Ttyzsx/telepole-survey-meter/30503_0.jpg

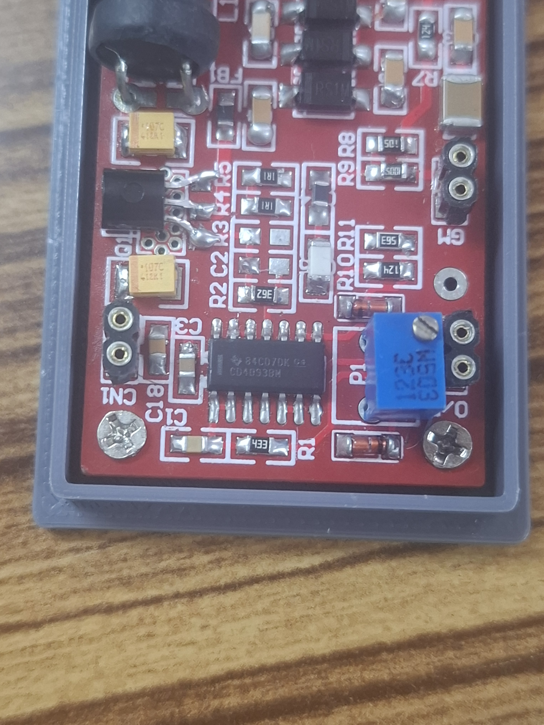
30503_0.jpg
