Ttyzsx/telepole-survey-meter/30507.jpg

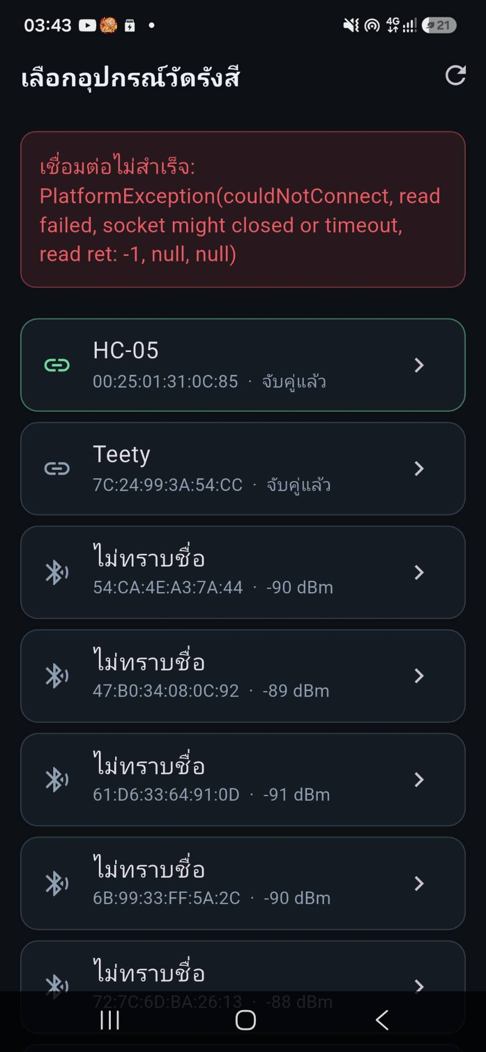
30507.jpg
