Ttyzsx/telepole-survey-meter/docs/telepole-manual-slides-v3.pptx

นำเสนอสรุปคู่มือ
ไกเกอร์เคาน์เตอร์ LND712 ทำงานอย่างไร
เดินตามสัญญาณหนึ่งเส้น ตั้งแต่รังสีเข้าหลอด จนถึงตัวเลขบนจอและเสียงเตือน

Notes: เปิดด้วยประโยคเดียว: คู่มือเล่มนี้พาสร้างไกเกอร์เคาน์เตอร์ที่วัดรังสีแล้วส่งค่าขึ้นมือถือ
บอกวิธีที่จะเล่า: ผมจะไม่ไล่ตามสารบัญ แต่จะเดินตามสัญญาณเส้นเดียวตั้งแต่รังสีเข้าหลอด
จนถึงเสียงเตือน เพราะทุกบรรทัดในโค้ดอยู่บนเส้นนี้หมด

## Slide 2

โครงเรื่อง

ทุกอย่างในเครื่องนี้อยู่บนสัญญาณเส้นเดียว

— สไลด์ต่อจากนี้ไล่ทีละขั้น พร้อมโค้ดจริงจากคู่มือที่รับผิดชอบขั้นนั้น
— กล่องสีเหลืองด้านขวาคือเหตุผลว่าทำไมคู่มือถึงเขียนแบบนั้น ซึ่งคู่มือไม่ได้อธิบายไว้
— รายการอุปกรณ์ ตารางขา และการแก้ปัญหา อยู่ในภาคผนวกท้ายเล่ม

รังสี
อนุภาคผ่านหลอด

พัลส์
0-5V เข้าขา D2

นับ
interrupt เก็บจำนวน

CPM
x6 ทุก 10 วินาที

หัก BG
ลบรังสีพื้นหลัง

uSv/h
x conversion factor

เตือน
เทียบ threshold

>

>

>

>

>

>

Notes: ชี้ที่โซ่แล้วอ่านจากซ้ายไปขวา: รังสีเข้าหลอด กลายเป็นพัลส์ นับด้วย interrupt
รวมเป็น CPM หักพื้นหลัง คูณ factor ได้ไมโครซีเวิร์ต แล้วเทียบเกณฑ์เตือน
บอกว่า 7 กล่องนี้คือ 7 สไลด์ถัดไป และแถบล่างของทุกหน้าจะบอกว่าอยู่ขั้นไหน

## Slide 3

ก่อนเข้าโค้ด

โครงสร้างของไฟล์ sketch ทั้งไฟล์

telepole_gm.ino — ภาพรวม

#include <Wire.h>

#include <Adafruit_SSD1306.h>

#include <Adafruit_GFX.h>

#include <SoftwareSerial.h>

// ตั้งค่าหน้าจอ OLED
#define SCREEN_WIDTH 128

#define SCREEN_HEIGHT 64

#define OLED_ADDR 0x3C

Adafruit_SSD1306 display(SCREEN_WIDTH, SCREEN_HEIGHT, &Wire, -1);
// กำหนดขาต่ออุปกรณ์
#define GEIGER_PIN 2 // พัลส์จากโมดูล HV (interrupt 0)

#define BUTTON_SEL 3 #define BUTTON_UP 4

#define BUTTON_DN 5 #define BUZZER_PIN 6

#define BT_RX 7 #define BT_TX 8

SoftwareSerial bluetooth(BT_RX, BT_TX);
// ฟังก์ชันทั้งหมดในไฟล์ มี 8 ตัว
countPulse() readButton() triggerAlert()
updateDisplay() sendBluetoothData() handleMenu()
setup() loop()

ฟังก์ชัน 8 ตัว แบ่งได้ 3 กลุ่ม
กลุ่มที่ 1 อยู่บนเส้นทางสัญญาณ — countPulse, triggerAlert, updateDisplay, sendBluetoothData
กลุ่มที่ 2 รับคำสั่งจากผู้ใช้ — readButton, handleMenu
กลุ่มที่ 3 โครงของโปรแกรม — setup ทำครั้งเดียว, loop วนตลอด
สไลด์ต่อจากนี้จะไล่ครบทั้ง 8 ตัว ไม่มีตกหล่น

Notes: หน้านี้ไว้ตอบล่วงหน้าว่าโค้ดทั้งไฟล์มีอะไรบ้าง จะได้ไม่มีใครสงสัยว่าข้ามอะไรไป
บอกว่าไฟล์เดียวจบ ไม่ได้แยกหลายไฟล์ และมีฟังก์ชัน 8 ตัว
ชี้ที่กล่องขวา แล้วบอกว่าจะเล่าเรียงตามเส้นทางสัญญาณ ไม่ใช่เรียงตามลำดับในไฟล์

## Slide 4

ขั้นที่ 1

จากรังสีกลายเป็นพัลส์ไฟฟ้า

— หลอด LND712 บรรจุแก๊ส มีขั้วไฟฟ้าต่างศักย์กัน ต้องการแรงดัน 450-650V
— อนุภาครังสีผ่านเข้าไป ทำให้แก๊สแตกตัว เกิดการนำไฟฟ้าชั่วขณะ
— ได้พัลส์แรงดันสั้นมาก หนึ่งลูกต่อหนึ่งอนุภาค
— โมดูลจ่ายแรงดันสูงจัดรูปพัลส์ให้เป็นสัญญาณ TTL 0-5V ก่อนส่งเข้า Arduino
— คู่มือแนะนำให้ตั้งแรงดันไว้ประมาณ 500V
— ขั้นนี้ยังไม่มีโค้ด เป็นฮาร์ดแวร์ล้วน

ข้อจำกัดที่ต้องรู้ตั้งแต่ต้น
หลอด GM บอกได้แค่ว่ามีอนุภาคผ่าน ไม่ได้บอกว่าเป็นรังสีชนิดใดหรือพลังงานเท่าไร
ทุกตัวเลขที่เหลือในเครื่องนี้จึงเป็นการตีความจากการนับล้วน ๆ
คู่มือเตือนว่า 400-550V เป็นอันตราย ต้องหุ้มฉนวนและระวังขณะต่อวงจร

1. พัลส์

2. นับ

3. CPM

4. หัก BG

5. µSv/h

6. เตือน

7. ส่งออก

Notes: เริ่มจากฟิสิกส์ก่อน อย่าเพิ่งเข้าโค้ด
อธิบายว่าหลอดคือหลอดแก๊สที่มีไฟแรงสูงคร่อมอยู่ พอมีอนุภาควิ่งผ่านก็ทำให้แก๊สแตกตัว
เกิดกระแสวูบเดียว ได้พัลส์ออกมาหนึ่งลูก
ย้ำประโยคสำคัญ: หลอดนับได้อย่างเดียว บอกชนิดรังสีไม่ได้ ตรงนี้จะใช้อ้างอิงอีกครั้งตอนขั้นที่ 5

## Slide 5

ขั้นที่ 2 · countPulse()

จับพัลส์ให้ครบด้วย Interrupt

countPulse() และการตั้งค่าใน setup()

volatile unsigned long pulseCount = 0;
// ฟังก์ชัน Interrupt: ทำงานทุกครั้งที่เกิดพัลส์
void countPulse() {
pulseCount++;
}
// ใน setup()
pinMode(GEIGER_PIN, INPUT);
attachInterrupt(digitalPinToInterrupt(GEIGER_PIN),
countPulse, RISING);

ทำไมต้องเป็นแบบนี้
พัลส์กว้างระดับไมโครวินาที ถ้าใช้ digitalRead ในลูปปกติจะอ่านไม่ทันและนับตกหล่น
ATmega328P มี external interrupt แค่ 2 ช่อง คือ D2 และ D3 จึงบังคับว่าสัญญาณต้องเข้าขานี้
โค้ดใน interrupt ยิ่งยาวยิ่งเสี่ยงพลาดพัลส์ลูกถัดไป จึงเหลือแค่บวกหนึ่ง
volatile บอกคอมไพเลอร์ว่าค่าถูกแก้จากนอกลูป ห้าม optimize ทิ้ง

1. พัลส์

2. นับ

3. CPM

4. หัก BG

5. µSv/h

6. เตือน

7. ส่งออก

Notes: หน้านี้เป็นหน้าที่ต้องเล่าให้ดีที่สุด เพราะเป็นจุดที่แสดงว่าเข้าใจจริง
อ่านโค้ดให้ฟังก่อน แค่ 3 บรรทัด แล้วถามกลับว่าทำไมฟังก์ชันมันสั้นแค่นี้
ตอบเอง: เพราะโค้ดใน interrupt ยิ่งยาวยิ่งเสี่ยงพลาดพัลส์ลูกถัดไป
แล้วอธิบาย volatile ว่าถ้าไม่ใส่ คอมไพเลอร์อาจมองว่าตัวแปรไม่เคยถูกแก้ในลูป แล้ว optimize ทิ้ง
ถ้าอาจารย์ถามว่าทำไมต้อง D2 ตอบว่าชิปมี external interrupt แค่ 2 ขา คือ D2 กับ D3

## Slide 6

ขั้นที่ 3 · loop()

นับสะสมแล้วแปลงเป็น CPM

ส่วนคำนวณใน loop()

const unsigned long SAMPLE_TIME = 10000; // 10 วินาที
const float MULTIPLIER = 60000.0 / SAMPLE_TIME; // = 6
if (millis() - lastSampleTime >= SAMPLE_TIME) {
// ปิด Interrupt ชั่วคราวขณะอ่านค่า pulseCount
noInterrupts();
unsigned long counts = pulseCount;
pulseCount = 0;
interrupts();
cpm = counts * MULTIPLIER;
}

ทำไมต้องปิด Interrupt ชั่วคราว
การอ่านค่าแล้วรีเซ็ตเป็นสองคำสั่ง ไม่ใช่คำสั่งเดียว
ถ้าพัลส์เข้ามาระหว่างสองคำสั่งนั้น มันจะถูกนับแล้วโดนล้างทิ้งทันที คือหายไปเลย
ปิดแค่สองบรรทัดจึงไม่ทำให้พลาดพัลส์ เพราะฮาร์ดแวร์จำสถานะค้างไว้ให้
คู่มือเลือก 10 วินาทีเพื่อให้ตัวเลขขึ้นเร็ว ไม่ต้องรอครบนาที

1. พัลส์

2. นับ

3. CPM

4. หัก BG

5. µSv/h

6. เตือน

7. ส่งออก

Notes: อธิบาย MULTIPLIER ก่อน: นับ 10 วินาที คูณ 6 ได้ค่าต่อนาที ไม่ต้องรอครบนาที
แล้วเน้นที่ noInterrupts จุดนี้อาจารย์น่าจะถาม
อธิบายว่าอ่านค่ากับรีเซ็ตเป็นคนละคำสั่ง ถ้าพัลส์แทรกตรงกลางจะหายไปเลย
เสริมว่าปิดแค่สองบรรทัดไม่ทำให้พลาดพัลส์ เพราะฮาร์ดแวร์จำไว้ให้ก่อน

## Slide 7

ขั้นที่ 4

หักค่ารังสีพื้นหลังออก

ส่วนหักพื้นหลังใน loop()

const float DEFAULT_BACKGROUND = 20.0; // CPM
float background = DEFAULT_BACKGROUND;
float adjustedCPM = cpm - background;
if (adjustedCPM < 0) adjustedCPM = 0;
// สูตรตามคู่มือ
// Adjusted_CPM = CPM - Background_CPM
// ถ้าติดลบ ให้แสดง 0 CPM / 0.00 uSv/h

ผลของการหักตรงนี้
คู่มือระบุว่ารังสีพื้นหลังจริงอยู่ราว 15-30 CPM ขึ้นกับสถานที่
วิธีหาค่า วัดในที่ที่ไม่มีแหล่งรังสีเพิ่มเติม 10-15 นาที แล้วเฉลี่ย
ตัวเลขที่เห็นจะสะท้อนเฉพาะรังสีที่เพิ่มมาจากแหล่งกำเนิด
ถ้าตั้งค่าพื้นหลังผิด ตัวเลขจะผิดตามไปทั้งหมด และย้อนดูค่าดิบไม่ได้

1. พัลส์

2. นับ

3. CPM

4. หัก BG

5. µSv/h

6. เตือน

7. ส่งออก

Notes: บอกว่าโลกเรามีรังสีพื้นหลังตลอดเวลา ประมาณ 15-30 CPM
ถ้าไม่หักออก เครื่องจะขึ้นตัวเลขตลอดทั้งที่ไม่มีแหล่งกำเนิด
อธิบายบรรทัด if adjustedCPM < 0 ว่ากันกรณีวัดได้ต่ำกว่าค่าที่ตั้งไว้ จะได้ไม่ขึ้นค่าติดลบ
ถ้าถูกถามข้อเสีย ตอบว่าถ้าตั้ง background ผิด ค่าที่ได้ผิดหมดและย้อนดูค่าดิบไม่ได้

## Slide 8

ขั้นที่ 5

แปลง CPM เป็นไมโครซีเวิร์ตต่อชั่วโมง

ส่วนแปลงหน่วย

const float DEFAULT_CONV_FACTOR = 0.00833;
float convFactor = DEFAULT_CONV_FACTOR;
doseRate = adjustedCPM * convFactor;
// ค่าที่คู่มือระบุไว้สำหรับ LND712
// 0.00833 จากโปรเจกต์ของ danjulio บน ESP32
// 0.00926 = 108 CPM ต่อ 1 uSv/h
// 0.00233 จากตาราง Conversion Factors บางชุด

ทำไมค่าถึงไม่ตรงกัน
หลอด GM ตอบสนองต่างกันตามพลังงานโฟตอน ค่าจึงผูกกับพลังงานอ้างอิงที่ใช้วัด
CPM คือค่าที่วัดได้จริง ส่วนไมโครซีเวิร์ตเป็นค่าเทียบเท่าที่ขึ้นกับสมมติฐาน
คู่มือจึงบอกว่าควรสอบเทียบกับเครื่องมือมาตรฐานหากมีความจำเป็น
และทำปุ่มให้แก้ค่านี้ได้ที่หน้าเครื่อง ไม่ต้อง flash ใหม่

1. พัลส์

2. นับ

3. CPM

4. หัก BG

5. µSv/h

6. เตือน

7. ส่งออก

Notes: จุดที่น่าสนใจของหน้านี้คือคู่มือให้มา 3 ค่า ไม่ใช่ค่าเดียว
อธิบายว่าเป็นเพราะหลอด GM ตอบสนองต่างกันตามพลังงานโฟตอน ค่าจึงผูกกับพลังงานอ้างอิง
ย้อนกลับไปที่ขั้นที่ 1: หลอดบอกชนิดรังสีไม่ได้ เลยแปลงเป็นค่าสัมบูรณ์ไม่ได้
สรุปให้ชัด: CPM คือของจริง ไมโครซีเวิร์ตคือค่าเทียบเท่า

## Slide 9

ขั้นที่ 6 · triggerAlert()

เทียบเกณฑ์แล้วส่งเสียงเตือน

triggerAlert() และการเรียกใช้ใน loop()

bool alertActive = false;
const unsigned long alertDuration = 500; // 0.5 วินาที
void triggerAlert() {
if (!alertActive) {
alertActive = true;
lastAlertTime = millis();
tone(BUZZER_PIN, 2000, alertDuration);
}
}
// ใน loop()
if (doseRate >= alertThreshold) {
triggerAlert();
} else {
alertActive = false;
}

ทำไมต้องมีตัวแปร alertActive
loop วนเร็วมาก ถ้าไม่มีตัวกันไว้ เสียงจะถูกสั่งซ้ำทุกรอบจนฟังเป็นเสียงรัว
หลักการคือเสียงเตือนต้องเริ่มและหยุดตอนสถานะเปลี่ยน ไม่ใช่เล่นซ้ำทุกรอบ
การตั้งกลับเป็นเท็จเมื่อค่าลดลง ทำให้ครั้งต่อไปที่เกินเกณฑ์ยังเตือนได้อีก
ค่าเริ่มต้นของเกณฑ์คือ 1.0 ไมโครซีเวิร์ตต่อชั่วโมง

1. พัลส์

2. นับ

3. CPM

4. หัก BG

5. µSv/h

6. เตือน

7. ส่งออก

Notes: ชี้ที่ if (!alertActive) แล้วถามว่าทำไมต้องเช็คก่อน
ตอบว่าถ้าไม่เช็ค พอค่าเกินเกณฑ์ค้างไว้ เสียงจะถูกสั่งใหม่ทุกรอบลูปจนฟังเป็นเสียงรัว
ชี้ที่ else ที่ตั้ง alertActive กลับเป็น false บอกว่านี่คือส่วนที่ทำให้เตือนซ้ำได้ในครั้งถัดไป
สรุปหลักการ: เสียงเตือนผูกกับการเปลี่ยนสถานะ ไม่ใช่ผูกกับรอบลูป

## Slide 10

ขั้นที่ 7 · updateDisplay() และ sendBluetoothData()

แสดงผลและส่งออก

sendBluetoothData() และแกนของ updateDisplay()

void sendBluetoothData() {
char buffer[50];
snprintf(buffer, sizeof(buffer),
"cpm=%.0f;uSv/h=%.2f\n", cpm, doseRate);
bluetooth.print(buffer);
}
// updateDisplay() แสดง 4 ค่าบนหน้าเดียว
display.clearDisplay();
display.print("CPM: "); display.println(cpm, 0);
display.print("Dose: "); display.print(doseRate, 2);
display.print("Alert: "); display.print(alertThreshold, 2);
display.print("Conv: "); display.print(convFactor, 5);
if (menuMode != 0) { /* แสดง Menu Mode ต่อท้าย */ }
display.display();

ทำไม snprintf ไม่ใช่ sprintf
sprintf ไม่รู้ขนาด buffer ถ้าข้อความยาวเกินจะเขียนทับหน่วยความจำข้างเคียง
บนไมโครคอนโทรลเลอร์ที่มี RAM แค่ 2 KB อาการที่ได้คือค้างหรือรีเซ็ตแบบหาสาเหตุไม่เจอ
snprintf รับขนาดไปด้วย จึงตัดข้อความแทนที่จะล้น
รูปแบบที่ส่งออกคือ cpm=124.00;uSv/h=1.03 ทุก 10 วินาที

1. พัลส์

2. นับ

3. CPM

4. หัก BG

5. µSv/h

6. เตือน

7. ส่งออก

Notes: อ่านรูปแบบข้อความที่ส่งออกให้ฟัง cpm เท่ากับเท่าไร ตามด้วย uSv/h
แล้วเน้นที่ snprintf ว่าทำไมไม่ใช้ sprintf
ตอบว่า sprintf ไม่รู้ขนาด buffer ถ้าข้อความยาวเกินจะเขียนทับหน่วยความจำข้างเคียง
บนบอร์ดที่มี RAM แค่ 2 KB อาการคือค้างหรือรีเซ็ตแบบหาสาเหตุไม่เจอ
ส่วน updateDisplay บอกสั้น ๆ ว่าแสดง 4 ค่าบนหน้าเดียว แล้วจบด้วย display.display()

## Slide 11

นอกเส้นทางสัญญาณ · readButton() handleMenu()

การตั้งค่าที่หน้าเครื่อง

readButton() และ handleMenu()

int readButton(int pin) {
if (digitalRead(pin) == LOW) { // Active Low
if ((millis() - lastButtonTime) > debounceDelay) {
lastButtonTime = millis();
return 1;
}
}
return 0;
}
void handleMenu() {
if (readButton(BUTTON_SEL)) {
menuMode = (menuMode + 1) % 4; // วนกลับ
delay(200);
}
if (menuMode == 1) {
if (readButton(BUTTON_UP)) convFactor += 0.0001;
if (readButton(BUTTON_DN) && convFactor > 0)
convFactor -= 0.0001;
}
// menuMode 2 = background +-1.0
// menuMode 3 = alertThreshold +-0.1
}

จุดที่ต้องอธิบายได้
ปุ่มตั้งเป็น INPUT_PULLUP ค่าปกติจึงเป็น HIGH กดแล้วลงกราวด์ได้ LOW
ข้อดีคือไม่ต้องใส่ตัวต้านทานภายนอกเพิ่ม
debounceDelay 200 ms กันหน้าสัมผัสกระเด้ง ซึ่งทำให้กดครั้งเดียวนับได้หลายครั้ง
มอด 4 ทำให้เมนูวนกลับหน้าแรกเอง ไม่ต้องมีปุ่ม Back
ทุกโหมดมีเงื่อนไขกันค่าติดลบ
สามค่าที่ปรับได้ คือค่าที่ใช้ในขั้นที่ 4 5 และ 6 พอดี

Notes: เกริ่นว่าสองฟังก์ชันนี้ไม่ได้อยู่บนเส้นทางสัญญาณ แต่เป็นทางที่ผู้ใช้แก้ค่าได้ที่หน้าเครื่อง
อธิบาย Active Low ว่าทำไมกดแล้วได้ LOW ไม่ใช่ HIGH เพราะตั้ง INPUT_PULLUP
อธิบาย debounce ว่าหน้าสัมผัสจริงมันกระเด้ง กดครั้งเดียวอาจนับได้หลายครั้ง
ชี้ที่ % 4 บอกว่าทำให้เมนูวนกลับเอง ไม่ต้องมีปุ่มถอยหลัง
ปิดท้าย: สามค่าที่ปรับได้ตรงกับขั้นที่ 4 5 6 บนเส้นทางสัญญาณพอดี

## Slide 12

โครงของโปรแกรม · setup()

เตรียมของครั้งเดียวตอนเปิดเครื่อง

setup()

void setup() {
Serial.begin(9600); // Serial Monitor สำหรับดีบัก
bluetooth.begin(9600); // HC-05 ใช้ 9600 baud
if (!display.begin(SSD1306_SWITCHCAPVCC, OLED_ADDR)) {
Serial.println(F("SSD1306 allocation failed"));
for (;;); // หยุดทำงานถ้าจอไม่เริ่ม
}
display.clearDisplay();
display.display();
delay(1000);
pinMode(GEIGER_PIN, INPUT);
pinMode(BUTTON_SEL, INPUT_PULLUP);
pinMode(BUTTON_UP, INPUT_PULLUP);
pinMode(BUTTON_DN, INPUT_PULLUP);
pinMode(BUZZER_PIN, OUTPUT);
attachInterrupt(digitalPinToInterrupt(GEIGER_PIN),
countPulse, RISING);
// แสดง Geiger Counter / LND712 Ready แล้ว delay(2000)
}

จุดที่น่าสังเกต
ถ้าจอเริ่มไม่สำเร็จ โปรแกรมหยุดด้วย for(;;) ไม่เดินต่อ
เป็นการตัดสินใจว่าเครื่องที่ไม่มีจอถือว่าใช้งานไม่ได้ ดีกว่าปล่อยให้เดินต่อแบบเงียบ ๆ
F() ที่ครอบข้อความ ทำให้ข้อความไปอยู่ใน flash แทน RAM ซึ่งมีแค่ 2 KB
ปุ่มเป็น INPUT_PULLUP ส่วนขาพัลส์เป็น INPUT ธรรมดา เพราะโมดูลขับสัญญาณมาให้แล้ว

Notes: ไล่จากบนลงล่าง: เปิด Serial สองตัว เริ่มจอ ตั้งขา แล้วเปิด interrupt
จุดที่ควรชี้คือ for(;;) ถ้าจอเริ่มไม่ได้ โปรแกรมหยุดเลย ไม่เดินต่อ
บอกว่าเป็นการตัดสินใจว่าเครื่องที่ไม่มีจอถือว่าใช้ไม่ได้ ดีกว่าเดินต่อแบบเงียบ ๆ
ถ้ามีเวลาให้พูดถึง F() ว่าย้ายข้อความไปเก็บใน flash แทน RAM

## Slide 13

โครงของโปรแกรม · loop()

loop คือเส้นทางสัญญาณทั้งเส้น

loop()

void loop() {
handleMenu(); // ทุกรอบ ปุ่มจะได้ไว
if (millis() - lastSampleTime >= SAMPLE_TIME) {
noInterrupts();
unsigned long counts = pulseCount;
pulseCount = 0;
interrupts();
cpm = counts * MULTIPLIER; // ขั้น 3
float adjustedCPM = cpm - background; // ขั้น 4
if (adjustedCPM < 0) adjustedCPM = 0;
doseRate = adjustedCPM * convFactor; // ขั้น 5
if (doseRate >= alertThreshold) { // ขั้น 6
triggerAlert();
} else {
alertActive = false;
}
updateDisplay(); // ขั้น 7
sendBluetoothData();
lastSampleTime = millis();
}
delay(50);
}

หน้านี้คือหน้าสรุป
ทุกขั้นที่เล่ามาทั้งหมด อยู่ในบล็อกเดียวนี้เรียงจากบนลงล่าง
handleMenu อยู่นอกบล็อก เพราะปุ่มต้องตอบสนองทันที ไม่ใช่ทุก 10 วินาที
delay(50) ท้ายลูปเป็นการถ่วงเวลาให้ปุ่มทำงานได้ทัน โดยไม่กินซีพียูทั้งหมด
ถ้าจำสไลด์อื่นไม่ได้ ให้จำหน้านี้หน้าเดียวก็เล่าได้ทั้งเรื่อง

Notes: หน้านี้คือหน้าที่มัดทุกอย่างเข้าด้วยกัน ใช้เวลากับหน้านี้มากหน่อย
ชี้คอมเมนต์ขั้น 3 4 5 6 7 ทางขวาของโค้ด แล้วบอกว่านี่คือเจ็ดขั้นที่เล่ามาทั้งหมด
อธิบายว่าทำไม handleMenu อยู่นอกบล็อก if เพราะปุ่มต้องไว ไม่ใช่รอ 10 วินาที
ปิดท้ายด้วย delay(50) ว่าเป็นการถ่วงเวลาไม่ให้ลูปกินซีพียูทั้งหมด

## Slide 14

ภาคผนวก

อุปกรณ์และการต่อสาย

อุปกรณ์ | ขาสัญญาณ | ต่อเข้า Arduino
โมดูลจ่ายแรงดันสูง | Pulse Output | D2 (Interrupt 0)
จอ OLED I2C | SDA / SCL | A4 / A5
ปุ่ม Select / Up / Down | Output | D3 / D4 / D5
Buzzer | Signal | D6
Bluetooth HC-05 | TX / RX | D7 / D8

— Arduino Pro Mini 5V 16MHz
— หลอด LND712
— โมดูลจ่ายแรงดันสูง 400-550V
— จอ OLED 0.96 นิ้ว SSD1306
— Bluetooth HC-05 หรือ HC-06
— ปุ่ม Tactile Switch 3 ตัว
— Buzzer แบบ Passive
— แบต Li-ion 3.7V หรือ Power Bank
— สายไฟ อุปกรณ์บัดกรี เบรดบอร์ด

Notes: หน้านี้ไม่ต้องอ่านทีละบรรทัด เปิดผ่านแล้วบอกว่าเป็นหน้าอ้างอิงไว้ตอบคำถาม
ถ้าอาจารย์ถามเรื่องขาไหนต่ออะไร ค่อยเปิดกลับมาหน้านี้
จุดที่ควรรู้ไว้ตอบ: จอ OLED ถ้าเป็นรุ่น 3.3V ต้องใช้ Level Shifter เพราะบอร์ดใช้ลอจิก 5V

## Slide 15

ภาคผนวก

ทดสอบ ปรับเทียบ แก้ปัญหา และอ้างอิง

การทดสอบและพลังงาน
— ทดสอบทีละส่วน ทั้งจอ ปุ่มกด Buzzer และ Bluetooth ก่อนต่อรวม
— ตรวจสัญญาณจากหลอดด้วย oscilloscope หรือ multimeter ที่วัดความถี่ได้
— Pro Mini 20-30 mA + จอ 20 mA + Bluetooth 30 mA รวม 80-100 mA แบต 18650 ใช้ได้ราว 20 ชั่วโมง
การแก้ปัญหาเบื้องต้น
— จอไม่แสดงผล ตรวจ I2C และสแกน address ด้วยโค้ด Scanner
— Bluetooth ไม่เชื่อมต่อ ตรวจสาย TX RX และ baud rate 9600
— ค่า CPM สูงผิดปกติ ตรวจสัญญาณรบกวน ลองเพิ่ม RC filter ที่ขาสัญญาณ
อ้างอิงและแนวทางพัฒนาต่อที่คู่มือเสนอ
— LND712 Datasheet · DIY Geiger Counter Reference · danjulio/Geiger-Counter · Conversion Factors จาก Apollo-NG
— บันทึกข้อมูลลง SD Card · แสดงกราฟแนวโน้ม · เพิ่มเซนเซอร์อุณหภูมิและความชื้น

Notes: หน้าปิด ใช้เวลาสั้น ๆ
บอกว่าคู่มือมีหัวข้อทดสอบและแก้ปัญหาไว้ให้ด้วย และเสนอแนวทางพัฒนาต่อไว้ 3 ข้อ
จบด้วยประโยคสรุป: ทุกตัวเลขในเครื่องนี้ย้อนกลับไปที่การนับพัลส์ได้ทั้งหมด
CPM คือค่าที่วัดได้จริง ส่วนไมโครซีเวิร์ตเป็นค่าเทียบเท่าที่ขึ้นกับค่าสอบเทียบ
แล้วเปิดให้ถาม
