Ttyzsx/telepole-survey-meter/docs/telepole-manual-slides.pptx

นำเสนอสรุปคู่มือ
ไกเกอร์เคาน์เตอร์ด้วย Arduino และหลอด LND712
สรุปคู่มือการสร้าง — หลักการทำงาน การต่อวงจร และโค้ดทั้งหมด

## Slide 2

ภาพรวมของเครื่องที่คู่มือพาสร้าง

— ไกเกอร์เคาน์เตอร์แบบพกพา วัดรังสีอัลฟา เบตา แกมมา และเอกซ์
— ใช้หลอด LND712 ร่วมกับ Arduino Pro Mini 5V
— แสดงผลบนจอ OLED แบบ I2C
— ปรับแก้ค่าภูมิหลัง แปลงหน่วย และตั้งค่าแจ้งเตือนด้วยเสียง
— ควบคุมด้วยปุ่มกด 3 ปุ่ม และส่งข้อมูลผ่าน Bluetooth ไปยังสมาร์ทโฟน
— โปรเจกต์จริงกำหนดให้ใช้ Arduino UNO ซึ่งเป็นชิป ATmega328P เดียวกัน โค้ดใช้ได้โดยไม่ต้องแก้ขา

01

## Slide 3

ส่วนประกอบฮาร์ดแวร์ 9 รายการ

— Arduino Pro Mini 5V 16MHz — บอร์ดไมโครคอนโทรลเลอร์หลัก
— หลอดไกเกอร์-มืลเลอร์ LND712 — ตรวจจับอัลฟา เบตา แกมมา เอกซ์
— โมดูลจ่ายแรงดันสูง 400-550V ควรมีขาสัญญาณ TTL pulse output
— จอ OLED 0.96 นิ้ว รุ่น SSD1306 แบบ I2C
— โมดูล Bluetooth HC-05 หรือ HC-06
— ปุ่มกด Tactile Switch 3 ตัว — Select, Up, Down
— ลำโพงหรือ Buzzer แบบ Passive
— แบตเตอรี่ Li-ion 3.7V พร้อมโมดูลชาร์จ USB หรือ Power Bank
— สายไฟ อุปกรณ์บัดกรี และเบรดบอร์ดสำหรับทดสอบ

02

## Slide 4

ข้อควรระวังด้านความปลอดภัย

— โมดูลจ่ายแรงดันสูงสร้างแรงดันไฟฟ้าสูงถึง 400-550V
— แรงดันระดับนี้อาจเป็นอันตรายได้
— ต้องใช้ความระมัดระวังขณะต่อวงจร
— ตรวจสอบฉนวนหุ้มทุกจุดให้เรียบร้อยก่อนจ่ายไฟ

03

## Slide 5

ตารางการเชื่อมต่อขา

อุปกรณ์ | ขาสัญญาณ | ต่อเข้า Arduino
โมดูลจ่ายแรงดันสูง | Pulse Output | D2 (Interrupt 0)
จอ OLED I2C | SDA | A4
จอ OLED I2C | SCL | A5
ปุ่ม Select | Output | D3
ปุ่ม Up | Output | D4
ปุ่ม Down | Output | D5
Buzzer | Signal | D6
Bluetooth HC-05 | TX เข้า Arduino | D7 (SoftwareSerial)
Bluetooth HC-05 | RX ออกจาก Arduino | D8 (SoftwareSerial)

OLED ใช้สาย I2C 4 เส้น คือ VCC GND SDA SCL · หากจอเป็นรุ่นแรงดัน 3.3V ควรใช้ Level Shifter สำหรับ SDA และ SCL เพราะบอร์ดใช้ลอจิก 5V

04

## Slide 6

หลักการที่ 1 การนับพัลส์ และที่ 2 การคำนวณ CPM

การนับพัลส์
— หลอด LND712 สร้างพัลส์แรงดันสั้น ๆ ทุกครั้งที่อนุภาครังสีผ่านเข้าไป
— โมดูลจ่ายแรงดันสูงปรับพัลส์ให้เป็นสัญญาณ TTL ช่วง 0-5V ส่งเข้าขา D2
— ใช้ interrupt เพื่อตรวจจับและนับจำนวนพัลส์อย่างแม่นยำ
การคำนวณ CPM
— CPM คือ Counts Per Minute จำนวนพัลส์ที่เกิดขึ้นใน 1 นาที
— CPM = (จำนวนพัลส์ในเวลา T วินาที) × (60 / T)
— คู่มือใช้วิธีสุ่มตัวอย่าง 10 วินาทีแล้วคูณด้วย 6 เพื่อให้แสดงผลรวดเร็วขึ้น
— ตั้ง SAMPLE_TIME เท่ากับ 10000 มิลลิวินาที

05

## Slide 7

หลักการที่ 3 Conversion Factor

— หลอดไกเกอร์แต่ละรุ่นมี Conversion Factor ที่แตกต่างกัน
— สำหรับ LND712 คู่มือระบุค่าที่นิยมใช้ไว้ 3 ค่า
— 0.00833 — ใช้ในโปรเจกต์ Geiger Counter บน ESP32 ของ danjulio
— 0.00926 — เท่ากับ 108 CPM ต่อ 1 µSv/h พบในเอกสารอ้างอิงบางแหล่ง
— 0.00233 — ตามตาราง Conversion Factors บางชุด
— คู่มือเลือก 0.00833 เป็นค่าเริ่มต้น และปรับเปลี่ยนได้ผ่านปุ่มตั้งค่า
— Dose (µSv/h) = CPM × Conversion_Factor

06

## Slide 8

หลักการที่ 4 Background และที่ 5 การแจ้งเตือน

Background Correction
— ค่ารังสีพื้นหลังมีประมาณ 15-30 CPM ขึ้นอยู่กับสถานที่
— Adjusted_CPM = CPM − Background_CPM
— หาก Adjusted_CPM ติดลบ ให้แสดงผลเป็น 0 CPM และ 0.00 µSv/h
— ค่าเริ่มต้นในโค้ดตั้งไว้ที่ 20 CPM
การแจ้งเตือนระดับรังสี
— เมื่อ Dose rate สูงเกิน Alert Threshold ที่ตั้งไว้ Arduino ส่งสัญญาณไปที่ Buzzer
— กำหนดความถี่และระยะเวลาการติดต่อกันได้
— ค่าเริ่มต้นของ Alert Threshold คือ 1.0 µSv/h

07

## Slide 9

ไลบรารีและค่าคงที่หลักในโค้ด

ไลบรารีที่ต้องติดตั้งใน Arduino IDE
— Adafruit SSD1306 — สำหรับจอ OLED
— Adafruit GFX — ฟังก์ชันกราฟิกสำหรับจอ
— SoftwareSerial — สำหรับ Bluetooth มีมากับ Arduino IDE อยู่แล้ว
ค่าคงที่หลัก
— SAMPLE_TIME = 10000 เก็บตัวอย่างทุก 10 วินาที
— MULTIPLIER = 60000 / SAMPLE_TIME ใช้เปลี่ยน CPS เป็น CPM
— DEFAULT_CONV_FACTOR = 0.00833 · DEFAULT_BACKGROUND = 20.0
— DEFAULT_ALERT_THRESHOLD = 1.0 · debounceDelay = 200 ms
— pulseCount ประกาศเป็น volatile เพราะถูกแก้ค่าจากฟังก์ชัน interrupt

08

## Slide 10

โค้ด: countPulse() และ readButton()

countPulse()
— เป็นฟังก์ชัน Interrupt ทำงานทุกครั้งที่เกิดพัลส์จากหลอดไกเกอร์
— ภายในมีคำสั่งเดียวคือ pulseCount++
readButton(int pin)
— อ่านสถานะปุ่มพร้อม debounce
— สมมติปุ่มต่อแบบ Active Low คือกดแล้วได้ LOW จึงเช็ค digitalRead(pin) == LOW
— เช็คต่อว่า millis() − lastButtonTime มากกว่า debounceDelay หรือไม่
— ผ่านทั้งสองเงื่อนไข บันทึกเวลาแล้วคืนค่า 1 ถ้าไม่ผ่านคืน 0

09

## Slide 11

โค้ด: triggerAlert() updateDisplay() sendBluetoothData()

triggerAlert()
— ทำงานเมื่อ alertActive ยังเป็นเท็จเท่านั้น
— ตั้ง alertActive เป็นจริง แล้วสั่ง tone(BUZZER_PIN, 2000, 500)
— การเช็ค alertActive ก่อน กันไม่ให้เสียงดังซ้ำทุกรอบลูป
updateDisplay()
— เคลียร์จอ ตั้งขนาดตัวอักษร สี และตำแหน่งเคอร์เซอร์
— แสดงค่า CPM, Dose, Alert และ Conv บนหน้าเดียว
— ถ้า menuMode ไม่เท่ากับ 0 จะแสดงข้อความ Menu Mode ต่อท้าย
sendBluetoothData()
— ใช้ snprintf แทน sprintf เพื่อจำกัดความยาว กันข้อมูลล้นออกนอก buffer

10

## Slide 12

โค้ด: handleMenu() ระบบเมนู 4 โหมด

— กดปุ่ม Select เปลี่ยนโหมดแบบวนกลับ ด้วย menuMode = (menuMode + 1) % 4
— โหมด 0 — หน้าหลักแสดงค่าปกติ
— โหมด 1 — แก้ไข Conversion Factor ปุ่ม Up/Down ปรับครั้งละ 0.0001
— โหมด 2 — แก้ไข Background ปรับครั้งละ 1.0 CPM
— โหมด 3 — แก้ไข Alert Threshold ปรับครั้งละ 0.1
— ทุกโหมดมีเงื่อนไขกันค่าติดลบ คือลดได้เฉพาะเมื่อค่าปัจจุบันมากกว่าศูนย์
— มี delay(200) หลังกด Select เพื่อป้องกันการกดซ้ำ

11

## Slide 13

โค้ด: setup() การเตรียมครั้งแรก

— Serial.begin(9600) สำหรับ Serial Monitor ไว้ดีบัก
— bluetooth.begin(9600) ซึ่งเป็น baud rate มาตรฐานของ HC-05
— เริ่มจอ OLED ถ้าไม่สำเร็จจะพิมพ์ SSD1306 allocation failed แล้วหยุดด้วยลูปไม่รู้จบ
— pinMode: GEIGER_PIN เป็น INPUT ปุ่มทั้งสามเป็น INPUT_PULLUP และ BUZZER เป็น OUTPUT
— attachInterrupt(digitalPinToInterrupt(GEIGER_PIN), countPulse, RISING)
— แสดงข้อความ Geiger Counter และ LND712 Ready แล้วหน่วง 2 วินาที

12

## Slide 14

โค้ด: loop() หัวใจของโปรแกรม

— เรียก handleMenu() ทุกรอบเพื่อให้ปุ่มตอบสนองไว
— ทุกครบ SAMPLE_TIME หรือ 10 วินาที จึงคำนวณใหม่
— สั่ง noInterrupts() ก่อนอ่าน pulseCount เก็บไว้ รีเซ็ตเป็นศูนย์ แล้วสั่ง interrupts() กลับ
— เหตุที่ต้องปิด Interrupt ชั่วคราว: ถ้ามีพัลส์เข้ามาระหว่างอ่านกับรีเซ็ต พัลส์นั้นจะหายไป
— cpm = counts × MULTIPLIER จากนั้นหัก background ได้ adjustedCPM ถ้าติดลบให้เป็นศูนย์
— doseRate = adjustedCPM × convFactor
— ถ้า doseRate ถึงเกณฑ์เรียก triggerAlert ถ้าไม่ถึงตั้ง alertActive กลับเป็นเท็จ
— เรียก updateDisplay() และ sendBluetoothData() แล้วรีเซ็ตเวลา
— ท้ายลูปมี delay(50) เพื่อให้ปุ่มทำงานได้ทันที

13

## Slide 15

การรับข้อมูลบนสมาร์ทโฟนผ่าน Bluetooth

— โค้ดส่งข้อมูลทุก 10 วินาที ในรูปแบบ cpm=124.00;uSv/h=1.03
— แอปที่ใช้รับได้ เช่น Serial Bluetooth Terminal ทั้ง Android และ iOS
— หรือ Arduino Bluetooth Data Logger หรือแอปที่พัฒนาเอง
— ขั้นตอนที่ 1 จับคู่ Bluetooth กับ HC-05 รหัสผ่านเริ่มต้นคือ 1234 หรือ 0000
— ขั้นตอนที่ 2 เปิดแอป Serial Terminal แล้วเลือกเชื่อมต่อกับ HC-05
— ขั้นตอนที่ 3 ข้อมูลจะแสดงเป็นข้อความทุก 10 วินาที
— HC-06 เป็น Slave-only ใช้โค้ดเดิมได้ แต่ส่งคำสั่งจากมือถือกลับมายัง Arduino ไม่ได้

14

## Slide 16

การทดสอบ การปรับเทียบ การแก้ปัญหา และสรุป

การทดสอบและพลังงาน
— ทดสอบทีละส่วน ทั้งจอ OLED ปุ่มกด Buzzer และ Bluetooth ก่อนต่อรวม
— ตั้งแรงดันประมาณ 500V เพราะ LND712 ต้องการช่วง 450-650V
— Pro Mini 20-30 mA + จอ 20 mA + Bluetooth 30 mA รวม 80-100 mA แบต 18650 ใช้ได้ราว 20 ชั่วโมง
การปรับเทียบ
— ตั้งค่า Background โดยวัดในที่ที่ไม่มีแหล่งรังสีเพิ่มเติม 10-15 นาที แล้วนำค่าเฉลี่ยมาใช้
การแก้ปัญหาเบื้องต้น
— จอไม่แสดงผล ตรวจ I2C และสแกน address · Bluetooth ไม่ต่อ ตรวจ TX RX และ baud 9600
— CPM สูงผิดปกติ ตรวจสัญญาณรบกวน ลองเพิ่ม RC filter ที่ขาสัญญาณ
แนวทางพัฒนาต่อที่คู่มือเสนอ
— บันทึกข้อมูลลง SD Card · แสดงกราฟแนวโน้ม · เพิ่มเซนเซอร์อุณหภูมิและความชื้น

15
