Ttyzsx/telepole-survey-meter/(commit log)

2026-08-26 feat: telepole GM survey meter firmware + flutter app
    - Arduino Nano firmware: INT0 pulse counting, 60s rolling CPM window,
    accumulated dose integration, CSV over HC-05 at 1 Hz
    - Flutter app: CPM as primary readout, derived uSv/h, app-side dose
    integration, adjustable tube sensitivity with field calibration
    - GitHub Actions workflow to build the release APK
2026-08-26 fix: swap to flutter_blue_classic, configurable pulse edge
    flutter_bluetooth_serial_ble still uses jcenter() which Gradle 7+ removed,
    so the release build failed while evaluating the plugin project.
    [telepole_gm.ino]
2026-08-26 docs: add checklist for homemade GM probes (pulse level, edge, HV plateau, calibration)
2026-08-26 fix: pin compileSdk to 37 so permission_handler 13 passes aar metadata check
2026-08-26 docs: record the actual CD4093-based GM module pinout and 5V logic output
    Also skip APK rebuilds for markdown-only pushes.
2026-08-26 docs: replace the speculative homemade-probe section with the real board
    The probe turned out to be a manufactured CD4093-based module with a 5V
    logic output, so the guidance about building an interface circuit no longer
    applies. Keeps only the checks that hold for this board.
    Also fix a firmware comment that described the opposite of the code, and
    skip APK rebuilds for firmware-only pushes.
    [telepole_gm.ino]
2026-08-26 feat: report raw per-second counts and add an audible count click
    CPM is a 60s rolling average, so it lags when sweeping for a hot spot.
    Firmware now also sends the raw count for the last second; the app shows it
    as CPS and uses it to drive a click sound, toggleable from the dashboard so
    it can be turned off when the probe board has its own buzzer.
    The CSV field is optional on the app side, so older firmware still works.
    [telepole_gm.ino]
2026-09-02 feat: record surveys to CSV, retarget to Uno + LND 712, resiren the alarm
    Three changes the professor asked for after seeing build #8.
    The board is an Arduino Uno, not a Nano. Same ATmega328P, so no pin changes
    — only the docs and comments were wrong.
    The tube is an LND 712, whose datasheet gives 18 CPS per mR/h (Co-60), i.e.
    108 CPM per uSv/h. That is now the default in both the firmware constant and
    the app's calibration, replacing the J305 guess. The field-calibration menu
    still overrides it without reflashing.
    The alarm was a repeated 2700 Hz double beep, which reads as a phone alarm
    clock — a sound people silence on reflex. It is now a 900->2400 Hz sweep
    repeated twice, which is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
    [telepole_gm.ino]
2026-09-03 feat: plot raw CPS on the live chart instead of averaged CPM
    The chart existed to find hot spots, but it plotted CPM, which is a
    60-second rolling average. Sweeping the probe across a source made the
    line ramp up over a minute and ramp back down long after the source was
    gone — the opposite of what a search display needs.
    It now plots the raw per-second count the firmware already sends, so the
    line tracks the probe immediately. The averaged CPM is still the large
    number at the top of the screen, where a stable reading belongs.
    The threshold lines are divided by 60 to land on the same axis, the
    y-axis holds a floor of 4 CPS so background noise doesn't fill the frame,
    and curve smoothing i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
2026-09-03 feat: let the live chart switch between raw CPS and averaged CPM
    The previous commit swapped the chart to raw CPS outright, which traded
    one problem for another: CPS tracks the probe instantly but jitters hard
    at background, and CPM reads cleanly but lags a full minute behind.
    Neither is correct on its own — which one you want depends on whether
    you are sweeping for a hot spot or reading a value.
    A two-segment toggle on the card header picks between them. The subtitle
    changes with it, so the trade-off is stated on screen rather than being
    something the operator has to remember.
    Threshold lines, the y-axis floor, curve smoothing and the tooltip all
    follow the selected metric. Line colour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
2026-09-03 docs(firmware): header comment still described the old 3-field CSV
    The CPS field was added a week ago and the startup banner already
    announces it, but the file header still listed three fields. Anyone
    reading the top of the sketch to learn the wire format got the wrong
    answer.
    [telepole_gm.ino]
2026-09-03 docs: upload steps still told you to select the Nano board
    Section 1 was retargeted to the Uno but the upload instructions were
    missed, so the one place a reader acts on the board name still said
    Nano — along with the Old Bootloader processor choice, which the Uno
    does not have.
2026-09-03 docs(firmware): add the manual's sketch as a runnable reference
    A classmate asked for the professor's code in a form they can download
    and upload, so this transcribes the sketch from the scanned manual
    (pages 4-12) into one compilable file, kept in its own folder so nobody
    mistakes it for the Telepole firmware.
    Three notes are recorded at the bottom rather than silently fixed: AVR's
    printf drops float support so the Bluetooth line prints '?' unless
    dtostrf is used, setup() prints the splash before setting a text colour,
    and all three buttons share one debounce timestamp. The code stays as
    the manual has it; the alternatives sit in comments.
    [geiger_counter_manual.ino]
2026-09-11 chore: ignore build artifacts and editor lock files
    APK ใน dist/ สร้างใหม่ได้จาก CI ทุก push · *.ino.bak เป็นไฟล์สำรอง
    ตอนไล่ปัญหาแรม · ~$*.pptx คือไฟล์ล็อกที่ PowerPoint ทิ้งไว้ระหว่างเปิดงาน
    Claude-Session: https://claude.ai/code/session_014ywotj2nBEDMPEVU3m4Gr9
2026-09-11 fix(firmware): ผังขาไม่ตรงกับสายที่เดินไว้จริง บลูทูธจึงไม่ทำงาน
    telepole_gm ตั้ง HC-05 ไว้ที่ D10/D11 แต่สายจริงเดินตามคู่มือคือ D7/D8
    แฟลชลงไปแล้วบลูทูธเงียบสนิทเพราะคุยผิดขา ซ้ำร้ายบัซเซอร์ตั้งไว้ที่ D8
    ซึ่งเป็นขา RXD ของ HC-05 พอดี โค้ดจึงยิงสัญญาณใส่ขารับของโมดูล
    แก้ให้ตรงคู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
    [telepole_gm_d10d11.ino]
2026-09-11 feat(firmware): สเก็ตช์รุ่นมีจอที่แก้ปัญหา SRAM หมดจนจอไม่ติด
    โค้ดจากคู่มือคอมไพล์ผ่านแต่รันแล้วจอดำสนิท สาเหตุคือ Adafruit_SSD1306
    จอง framebuffer 1024 B ตอน begin() ซึ่งเป็นครึ่งหนึ่งของ SRAM ทั้งก้อน
    พอ SoftwareSerial ของ HC-05 กินอีก 117 B แรมที่เหลือก็ต่ำกว่าเพดาน
    1152 B ที่ malloc ต้องการ begin() คืน NULL แล้วโค้ดค้างท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
2026-09-11 docs: สไลด์สรุปคู่มือสร้างไกเกอร์เคาน์เตอร์
    สรุปเนื้อหาจากคู่มือสแกน 15 หน้าที่อาจารย์มอบให้ เก็บไว้ 3 เวอร์ชัน
    พร้อมฉบับ markdown ที่ใช้เป็นต้นทางในการทำสไลด์
    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
2026-09-11 feat(app): จำค่าสอบเทียบและเกณฑ์เตือนไว้ข้ามการเปิด-ปิดแอป
    เดิมค่า sensitivity อยู่ในหน่วยความจำอย่างเดียว ปิดแอปแล้วเปิดใหม่จะกลับไป
    เป็นค่า datasheet 108 เงียบ ๆ โดยไม่มีอะไรเตือน ซึ่งอันตรายเพราะกว่าจะได้
    ค่าสอบเทียบมาต้องเอาหัววัดไปวางข้างเครื่องมาตรฐานที่ภาคว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
2026-09-11 fix(firmware): เลย์เอาต์จอ OLED เว้นช่องว่างทิ้งกลางจอ และไม่เคยแสดงค่า Background
    อาจารย์ติว่าบรรทัดบนจอห่างเกินไป แต่ขณะเดียวกันก็ใส่ข้อมูลได้ไม่ครบ
    สาเหตุคือโค้ดวางข้อความไว้แถว 0,1,2,4,6 ข้ามแถว 3 กับ 5 ทิ้ง จอ 128x64
    มี 8 แถวแต่ใช้จริงแค่ 5 เหลือช่องว่างคาอยู่กลางจอสองช่อง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
    [geiger_counter_improved_d7d8.ino]
2026-09-17 feat(app): read the cpm=...;uSv/h=... lines sent by gm_final
    gm_final prints key=value pairs every 10 s instead of CSV, so every line
    was silently dropped. Also raise the dose-integration gap limit to 30 s so
    10 s packets arriving slightly late still count.
